cibomahto/Popped/PoppingUnit-Case/PoppingUnitStackup.SLDASM

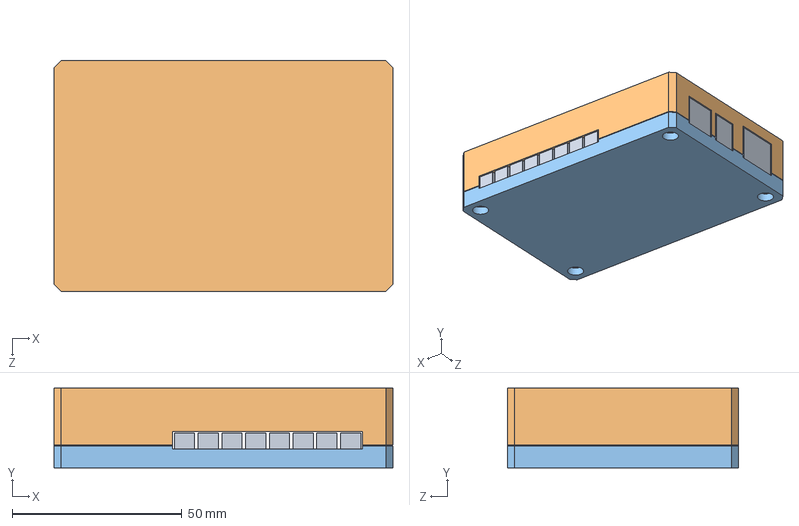
[picture p1: CAD file, 2014-03-11]
PoppingUnit-Case/PoppingUnitStackup.SLDASM
100.0 x 23.5 x 68.0 mm
PoppingUnitPCB
PoppingUnitTop
PoppingUnitBottom
