cibomahto/Popped/PoppingUnit-Case/PoppingUnitBottom.SLDPRT

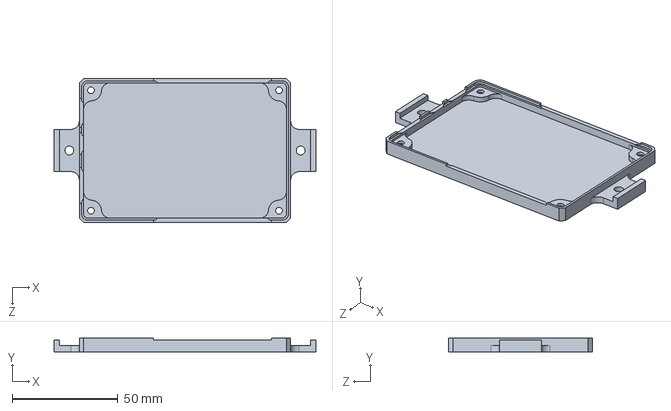
[picture p2: CAD file, 2014-03-11]
PoppingUnit-Case/PoppingUnitBottom.SLDPRT
124.0 x 6.50 x 68.0 mm
