cibomahto/Popped/PoppingUnit-Case/PoppingUnitTop.SLDPRT

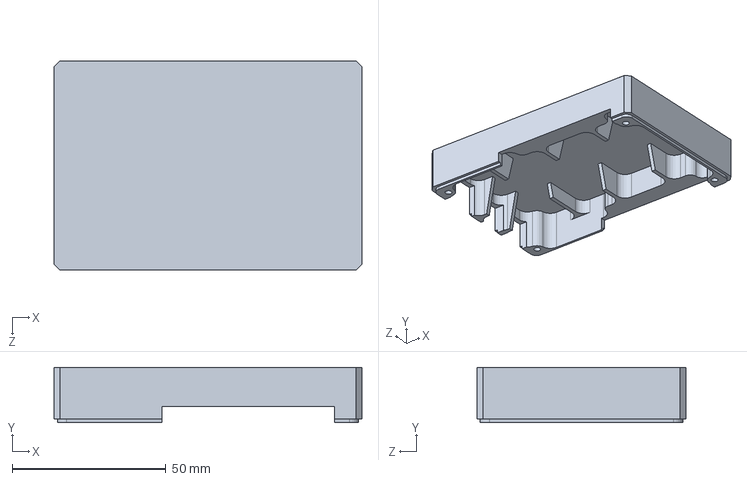
[picture p3: CAD file, 2014-03-11]
PoppingUnit-Case/PoppingUnitTop.SLDPRT
100.0 x 18.0 x 68.0 mm
