cibomahto/Popped/PoppingUnit-Case/PoppingUnitPCB.SLDPRT

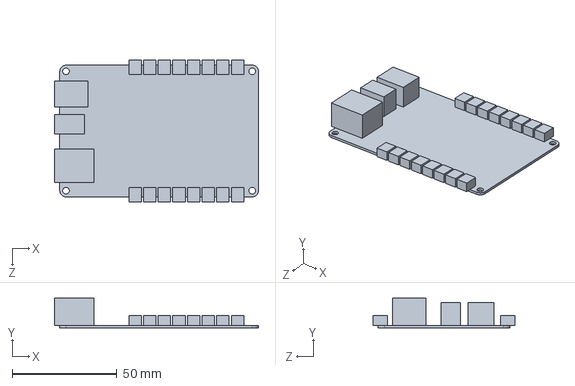
[picture p4: CAD file, 2014-03-05]
PoppingUnit-Case/PoppingUnitPCB.SLDPRT
97.5 x 14.2 x 68.0 mm
