cibomahto/Popped/(list of files, cad)

Other CAD files:
PoppingUnit-Case/PoppingUnitBottom.SLDDRW
PoppingUnit-Case/PoppingUnitTop.SLDDRW
