cibomahto/Popped/PoppingUnit-PCB/PoppingUnit.brd

## EAGLE design PoppingUnit-PCB/PoppingUnit.brd (2014-03-24)

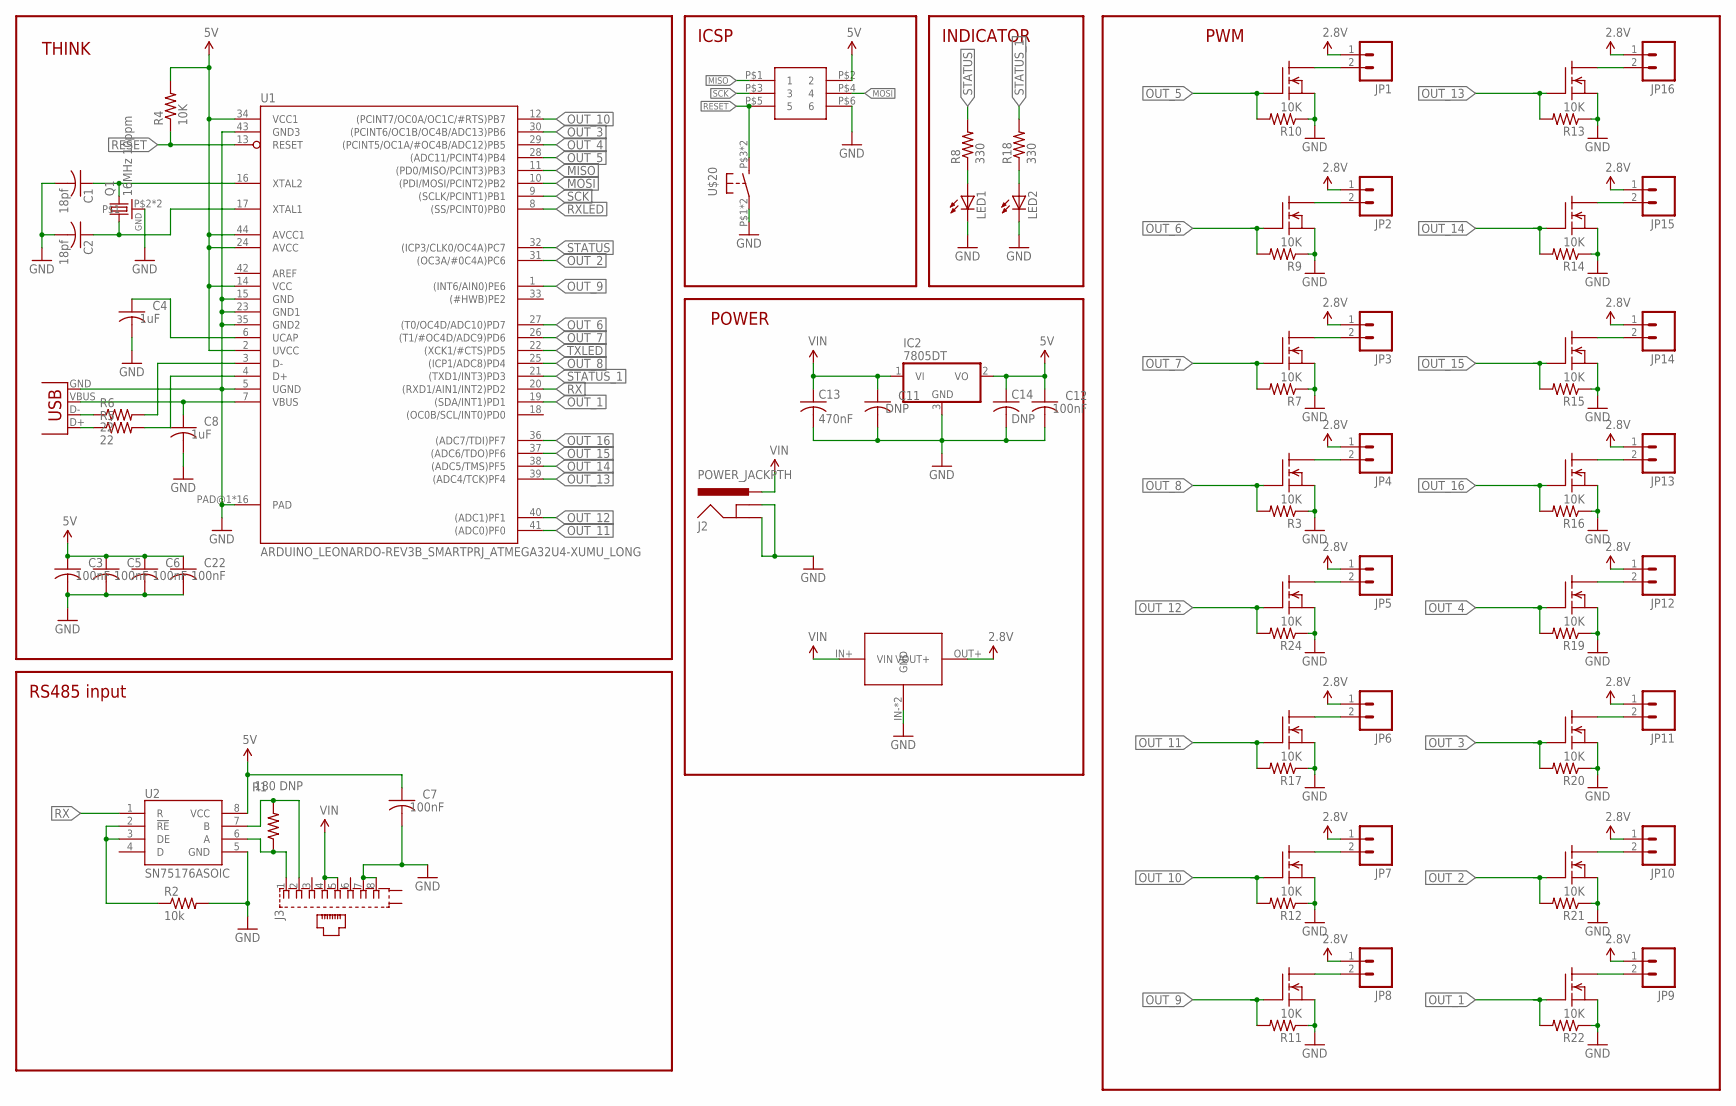
[picture p5: schematic PoppingUnit.sch]

Parts:
C1, C2: 18pf; C0603K
C3, C5, C6, C7, C12, C22: 100nF; C0603K
C4, C8: 1uF; C0603K
C11, C14: DNP; C0603K
C13: 470nF; C0603K
IC2: 7805DT; TO252
J2: POWER_JACKPTH; POWER_JACK_PTH
J3: 555153-1
JP1, JP2, JP3, JP4, JP5, JP6, JP7, JP8, JP9, JP10, JP11, JP12, JP13, JP14, JP15, JP16: M02-JST-2-PTH-NO_SILK; JST-2-PTH-NS
LED1, LED2: LED5MM
Q1: 16MHz 10ppm; CRSYTAL_2520
R1: 180 DNP; R0603
R2: 10k; R0603
R3, R4, R7, R9, R10, R11, R12, R13, R14, R15, R16, R17, R19, R20, R21, R22, R24: 10K; R0603
R5, R6: 22; R0603
R8, R18: 330; R0603
U1: ARDUINO_LEONARDO-REV3B_SMARTPRJ_ATMEGA32U4-XUMU_L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; QFN44ML7X7_LONGLEADS
U2: SN75176ASOIC; SO08
U$1, U$3, U$4, U$5, U$6, U$7, U$8, U$9, U$10, U$11, U$12, U$14, U$15, U$16, U$17, U$18: N_MOSFET; TO252
U$2: 2X3HEADER
U$19: DC_DC; DSN2596
U$20: BUTTON_MOMENTARY; BUTTON_MOMENTARY_KMR211G
X1: USBPTH; USB-B-PTH

Connections:
2.8V: JP1.1, JP2.1, JP3.1, JP4.1, JP5.1, JP6.1, JP7.1, JP8.1, JP9.1, JP10.1, JP11.1, JP12.1, JP13.1, JP14.1, JP15.1, JP16.1, U$19.OUT+ (VOUT+)
5V: C3.1, C5.1, C6.1, C7.1, C12.1, C14.1, C22.1, IC2.2 (VO), R4.2, U1.2 (UVCC), U1.14 (VCC), U1.24 (AVCC), U1.34 (VCC1), U1.44 (AVCC1), U2.8 (VCC), U$2.P$2 (2)
AREF: U1.42 (AREF)
CONNECT_ME: R2.1, U2.2 (!RE), U2.3 (DE)
GND: C1.2, C2.2, C3.2, C4.2, C5.2, C6.2, C7.2, C8.2, C11.2, C12.2, C13.2, C14.2, C22.2, IC2.3 (GND), J2.GND, J2.GNDBREAK, J3.7, J3.8, LED1.K (C), LED2.K (C), Q1.P$2, Q1.P$4, R2.2, R3.1, R7.1, R9.1, R10.1, R11.1, R12.1, R13.1, R14.1, R15.1, R16.1, R17.1, R19.1, R20.1, R21.1, R22.1, R24.1, U1.5 (UGND), U1.15 (GND), U1.23 (GND1), U1.35 (GND2), U1.43 (GND3), U1.PAD@1 (PAD), U1.PAD@2 (PAD), U1.PAD@3 (PAD), U1.PAD@4 (PAD), U1.PAD@5 (PAD), U1.PAD@6 (PAD), U1.PAD@7 (PAD), U1.PAD@8 (PAD), U1.PAD@9 (PAD), U1.PAD@10 (PAD), U1.PAD@11 (PAD), U1.PAD@12 (PAD), U1.PAD@13 (PAD), U1.PAD@14 (PAD), U1.PAD@15 (PAD), U1.PAD@16 (PAD), U2.5 (GND), U$1.P$2 (S), U$2.P$6 (6), U$3.P$2 (S), U$4.P$2 (S), U$5.P$2 (S), U$6.P$2 (S), U$7.P$2 (S), U$8.P$2 (S), U$9.P$2 (S), U$10.P$2 (S), U$11.P$2 (S), U$12.P$2 (S), U$14.P$2 (S), U$15.P$2 (S), U$16.P$2 (S), U$17.P$2 (S), U$18.P$2 (S), U$19.IN- (GND), U$19.OUT- (GND), U$20.P$1, U$20.P$2, X1.GND
MISO: U1.11 ((PD0/MISO/PCINT3)PB3), U$2.P$1 (1)
MOSI: U1.10 ((PDI/MOSI/PCINT2)PB2), U$2.P$4 (4)
unnamed: R6.1, X1.D-
unnamed: C1.1, Q1.P$3 (2), U1.16 (XTAL2)
unnamed: R5.1, X1.D+
unnamed: R5.2, U1.4 (D+)
unnamed: C2.1, Q1.P$1 (1), U1.17 (XTAL1)
unnamed: R6.2, U1.3 (D-)
unnamed: C8.1, U1.7 (VBUS), X1.VBUS
unnamed: LED1.A, R8.1
unnamed: C4.1, U1.6 (UCAP)
unnamed: JP11.2, U$16.P$3 (D)
unnamed: JP1.2, U$1.P$3 (D)
unnamed: LED2.A, R18.1
unnamed: JP2.2, U$3.P$3 (D)
unnamed: JP3.2, U$4.P$3 (D)
unnamed: JP4.2, U$5.P$3 (D)
unnamed: JP5.2, U$10.P$3 (D)
unnamed: JP6.2, U$11.P$3 (D)
unnamed: JP7.2, U$12.P$3 (D)
unnamed: JP8.2, U$14.P$3 (D)
unnamed: JP9.2, U$18.P$3 (D)
unnamed: JP10.2, U$17.P$3 (D)
unnamed: JP12.2, U$15.P$3 (D)
unnamed: JP13.2, U$9.P$3 (D)
unnamed: JP14.2, U$8.P$3 (D)
unnamed: JP15.2, U$7.P$3 (D)
unnamed: JP16.2, U$6.P$3 (D)
OUT_1: R22.2, U1.19 ((SDA/INT1)PD1), U$18.P$1 (G)
OUT_2: R21.2, U1.31 ((OC3A/#0C4A)PC6), U$17.P$1 (G)
OUT_3: R20.2, U1.30 ((PCINT6/OC1B/OC4B/ADC13)PB6), U$16.P$1 (G)
OUT_4: R19.2, U1.29 ((PCINT5/OC1A/#OC4B/ADC12)PB5), U$15.P$1 (G)
OUT_5: R10.2, U1.28 ((ADC11/PCINT4)PB4), U$1.P$1 (G)
OUT_6: R9.2, U1.27 ((T0/OC4D/ADC10)PD7), U$3.P$1 (G)
OUT_7: R7.2, U1.26 ((T1/#OC4D/ADC9)PD6), U$4.P$1 (G)
OUT_8: R3.2, U1.25 ((ICP1/ADC8)PD4), U$5.P$1 (G)
OUT_9: R11.2, U1.1 ((INT6/AIN0)PE6), U$14.P$1 (G)
OUT_10: R12.2, U1.12 ((PCINT7/OC0A/OC1C/#RTS)PB7), U$12.P$1 (G)
OUT_11: R17.2, U1.41 ((ADC0)PF0), U$11.P$1 (G)
OUT_12: R24.2, U1.40 ((ADC1)PF1), U$10.P$1 (G)
OUT_13: R13.2, U1.39 ((ADC4/TCK)PF4), U$6.P$1 (G)
OUT_14: R14.2, U1.38 ((ADC5/TMS)PF5), U$7.P$1 (G)
OUT_15: R15.2, U1.37 ((ADC6/TDO)PF6), U$8.P$1 (G)
OUT_16: R16.2, U1.36 ((ADC7/TDI)PF7), U$9.P$1 (G)
RESET: R4.1, U1.13 (RESET), U$2.P$5 (5), U$20.P$3 (S), U$20.P$4 (S)
RS485A: J3.1, R1.1, U2.6 (A)
RS485B: J3.2, R1.2, U2.7 (B)
RX: U1.20 ((RXD1/AIN1/INT2)PD2), U2.1 (R)
RXLED: U1.8 ((SS/PCINT0)PB0)
SCK: U1.9 ((SCLK/PCINT1)PB1), U$2.P$3 (3)
STATUS: R8.2, U1.32 ((ICP3/CLK0/OC4A)PC7)
STATUS_1: R18.2, U1.21 ((TXD1/INT3)PD3)
TXLED: U1.22 ((XCK1/#CTS)PD5)
VIN: C11.1, C13.1, IC2.1 (VI), J2.PWR, J3.4, J3.5, U$19.IN+ (VIN)

Notes on the sheet:
RS485 input
ICSP
INDICATOR
PWM
POWER
THINK

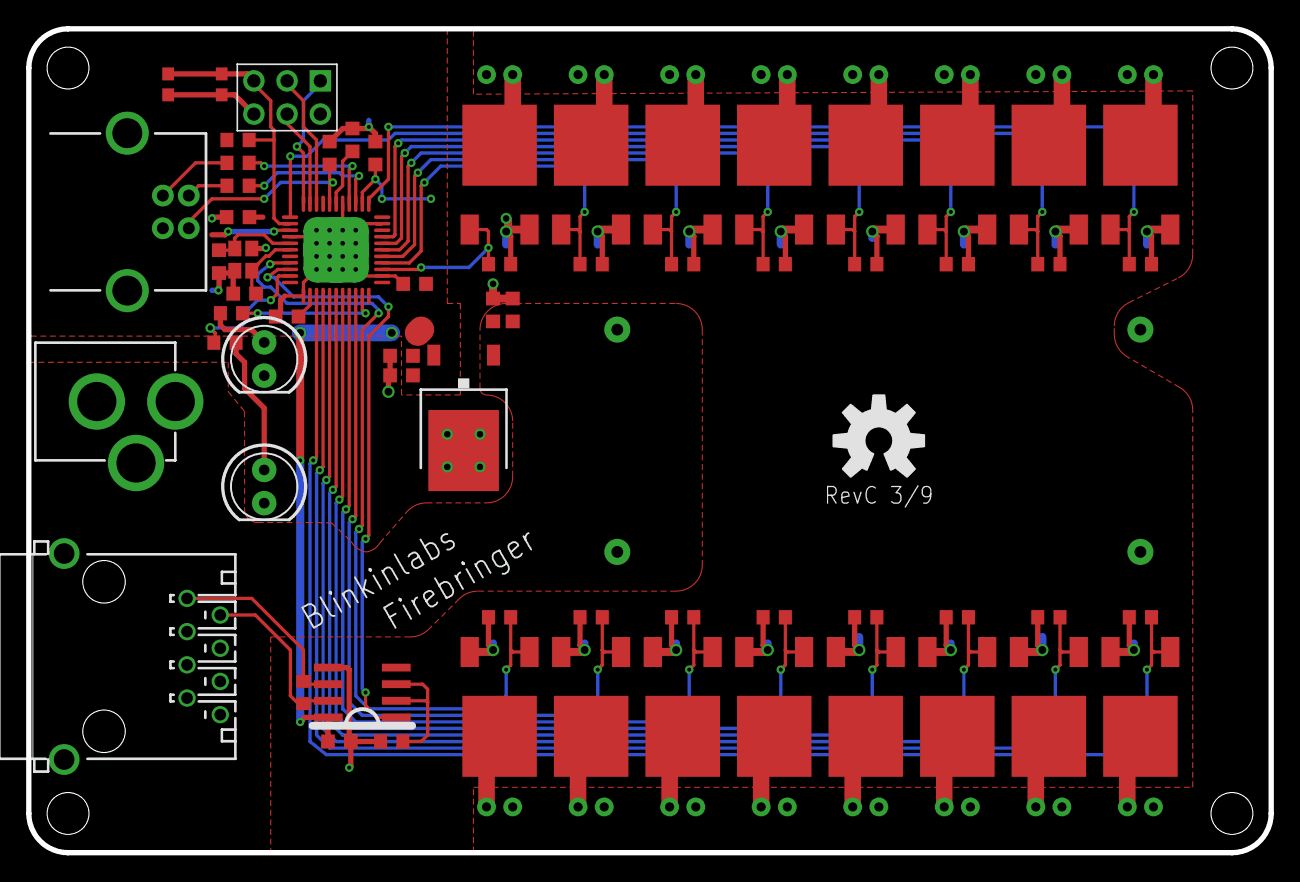
[picture p6: board PoppingUnit.brd from above]

Board: 2 copper layers, 95.0 x 63.0 mm, 81 parts (0 on the bottom side), 56 nets.

Other parts of the board:
U$13: OSHW-LOGO-L
