cibomahto/Popped/PowerDistribution-PCB/PowerDistribution.brd

## EAGLE design PowerDistribution-PCB/PowerDistribution.brd (2014-03-08)

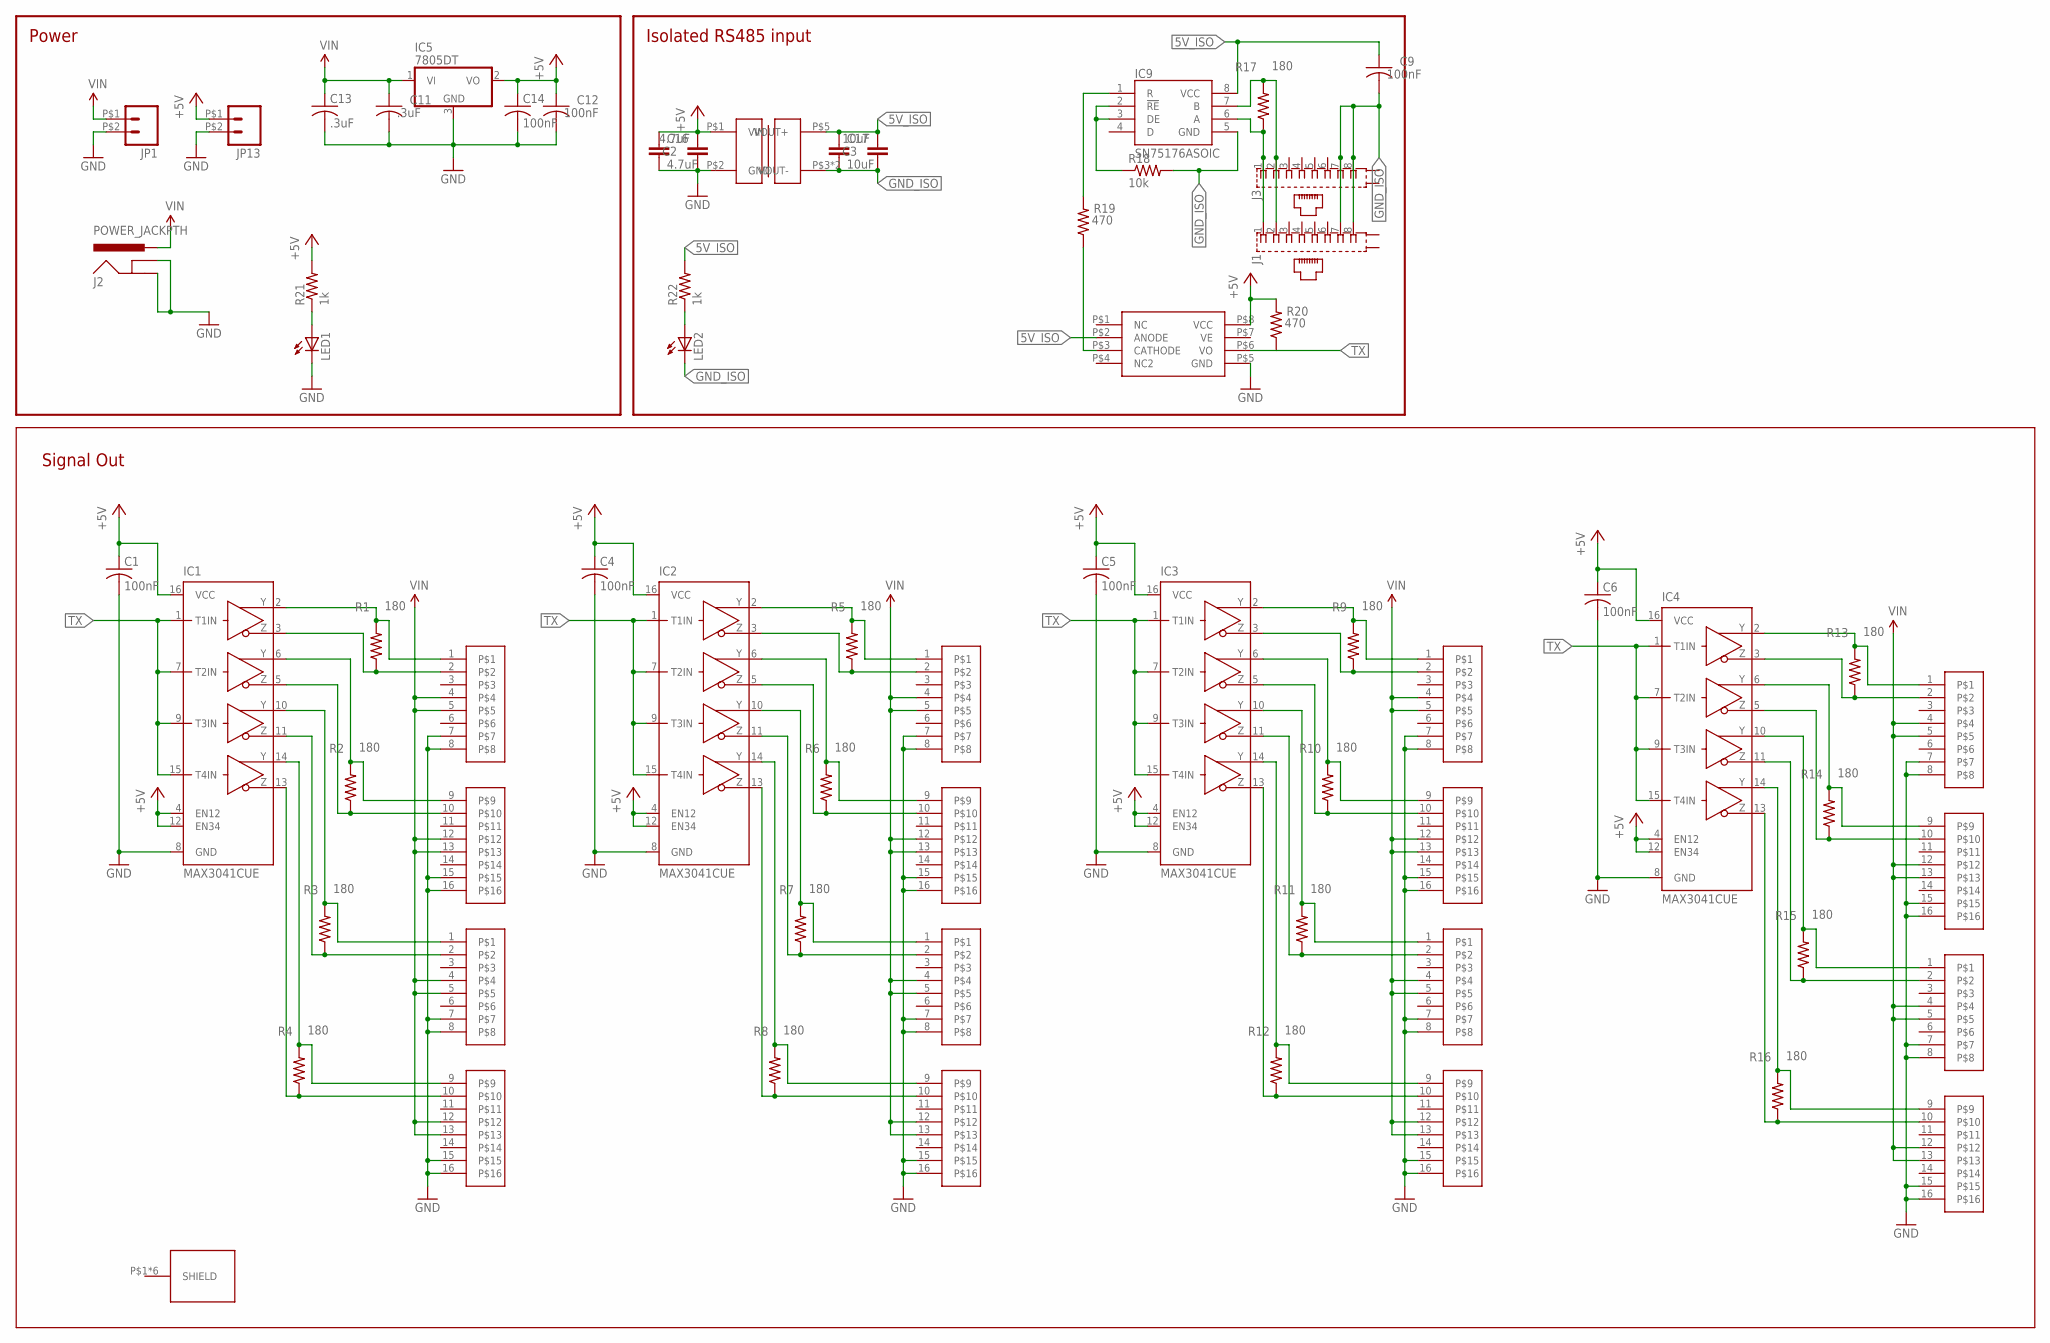
[picture p7: schematic PowerDistribution.sch]

Parts:
C1, C4, C5, C6, C9: 100nF; C0603
C2: 4.7uF; 0805
C3: 10uF; 0805
C11, C13: .3uF; C0603K
C12, C14: 100nF; C0603K
C16: 4.7uF; 1210
C17: 10uF; 1210
IC1, IC2, IC3, IC4: MAX3041CUE; TSSOP16
IC5: 7805DT; TO252
IC9: SN75176ASOIC; SO08
J1, J3: 555153-1
J2: POWER_JACKPTH; POWER_JACK_PTH
JP1, JP13: M026.35MM; SCREWTERMINAL-6.35MM-2
LED1, LED2: LED5MM
R1, R2, R3, R4, R5, R6, R7, R8, R9, R10, R11, R12, R13, R14, R15, R16, R17: 180; R0603
R18: 10k; R0603
R19, R20: 470; R0603
R21, R22: 1k; R0603
U$1, U$2, U$5, U$6, U$7, U$8, U$9, U$11: RJ45_8X2_JACK
U$3: 6N137; 8_SOIC
U$4: RJ45_8X2_BASE
U$10: DC_DC_ISOLATED_0505; IB_XLS-1W

Connections:
5V_ISO: C3.2, C9.1, C17.1, IC9.8 (VCC), R22.2, U$3.P$2 (ANODE), U$10.P$5 (VOUT+)
+5V: C1.1, C2.2, C4.1, C5.1, C6.1, C12.1, C14.1, C16.1, IC1.4 (EN12), IC1.12 (EN34), IC1.16 (VCC), IC2.4 (EN12), IC2.12 (EN34), IC2.16 (VCC), IC3.4 (EN12), IC3.12 (EN34), IC3.16 (VCC), IC4.4 (EN12), IC4.12 (EN34), IC4.16 (VCC), IC5.2 (VO), JP13.P$1 (1), R20.2, R21.2, U$3.P$8 (VCC), U$10.P$1 (VIN)
D9: IC9.2 (!RE), IC9.3 (DE), R18.1
GND: C1.2, C2.1, C4.2, C5.2, C6.2, C11.2, C12.2, C13.2, C14.2, C16.2, IC1.8 (GND), IC2.8 (GND), IC3.8 (GND), IC4.8 (GND), IC5.3 (GND), J2.GND, J2.GNDBREAK, JP1.P$2 (2), JP13.P$2 (2), LED1.K (C), U$1.7, U$1.8, U$1.15, U$1.16, U$2.7, U$2.8, U$2.15, U$2.16, U$3.P$5 (GND), U$5.7, U$5.8, U$5.15, U$5.16, U$6.7, U$6.8, U$6.15, U$6.16, U$7.7, U$7.8, U$7.15, U$7.16, U$8.7, U$8.8, U$8.15, U$8.16, U$9.7, U$9.8, U$9.15, U$9.16, U$10.P$2 (GND), U$11.7, U$11.8, U$11.15, U$11.16
GND_ISO: C3.1, C9.2, C17.2, IC9.5 (GND), J1.7, J1.8, J3.7, J3.8, LED2.K (C), R18.2, U$10.P$3 (VOUT-), U$10.P$4 (VOUT-)
unnamed: R19.1, U$3.P$3 (CATHODE)
unnamed: IC1.2 (Y1), R1.2, U$5.1
unnamed: IC9.1 (R), R19.2
unnamed: IC1.3 (Z1), R1.1, U$5.2
unnamed: IC1.13 (Z4), R4.1, U$8.10
unnamed: IC1.14 (Y4), R4.2, U$8.9
unnamed: IC1.11 (Z3), R3.1, U$8.2
unnamed: IC2.2 (Y1), R5.2, U$1.1
unnamed: IC1.10 (Y3), R3.2, U$8.1
unnamed: IC1.5 (Z2), R2.1, U$5.10
unnamed: IC1.6 (Y2), R2.2, U$5.9
unnamed: IC2.3 (Z1), R5.1, U$1.2
unnamed: IC2.13 (Z4), R8.1, U$2.10
unnamed: IC2.14 (Y4), R8.2, U$2.9
unnamed: IC2.11 (Z3), R7.1, U$2.2
unnamed: IC2.5 (Z2), R6.1, U$1.10
unnamed: IC2.6 (Y2), R6.2, U$1.9
unnamed: IC2.10 (Y3), R7.2, U$2.1
unnamed: IC3.2 (Y1), R9.2, U$6.1
unnamed: IC3.3 (Z1), R9.1, U$6.2
unnamed: IC3.13 (Z4), R12.1, U$7.10
unnamed: IC3.14 (Y4), R12.2, U$7.9
unnamed: IC3.11 (Z3), R11.1, U$7.2
unnamed: IC3.5 (Z2), R10.1, U$6.10
unnamed: IC3.6 (Y2), R10.2, U$6.9
unnamed: IC3.10 (Y3), R11.2, U$7.1
unnamed: IC4.2 (Y1), R13.2, U$9.1
unnamed: IC4.3 (Z1), R13.1, U$9.2
unnamed: IC4.13 (Z4), R16.1, U$11.10
unnamed: IC4.14 (Y4), R16.2, U$11.9
unnamed: IC4.11 (Z3), R15.1, U$11.2
unnamed: IC4.5 (Z2), R14.1, U$9.10
unnamed: IC4.6 (Y2), R14.2, U$9.9
unnamed: IC4.10 (Y3), R15.2, U$11.1
unnamed: LED1.A, R21.1
unnamed: LED2.A, R22.1
RS485A9: IC9.6 (A), J1.1, J3.1, R17.1
RS485B9: IC9.7 (B), J1.2, J3.2, R17.2
TX: IC1.1 (T1IN), IC1.7 (T2IN), IC1.9 (T3IN), IC1.15 (T4IN), IC2.1 (T1IN), IC2.7 (T2IN), IC2.9 (T3IN), IC2.15 (T4IN), IC3.1 (T1IN), IC3.7 (T2IN), IC3.9 (T3IN), IC3.15 (T4IN), IC4.1 (T1IN), IC4.7 (T2IN), IC4.9 (T3IN), IC4.15 (T4IN), R20.1, U$3.P$6 (VO)
VIN: C11.1, C13.1, IC5.1 (VI), J2.PWR, JP1.P$1 (1), U$1.4, U$1.5, U$1.12, U$1.13, U$2.4, U$2.5, U$2.12, U$2.13, U$5.4, U$5.5, U$5.12, U$5.13, U$6.4, U$6.5, U$6.12, U$6.13, U$7.4, U$7.5, U$7.12, U$7.13, U$8.4, U$8.5, U$8.12, U$8.13, U$9.4, U$9.5, U$9.12, U$9.13, U$11.4, U$11.5, U$11.12, U$11.13

Notes on the sheet:
Isolated RS485 input
Signal Out
Power

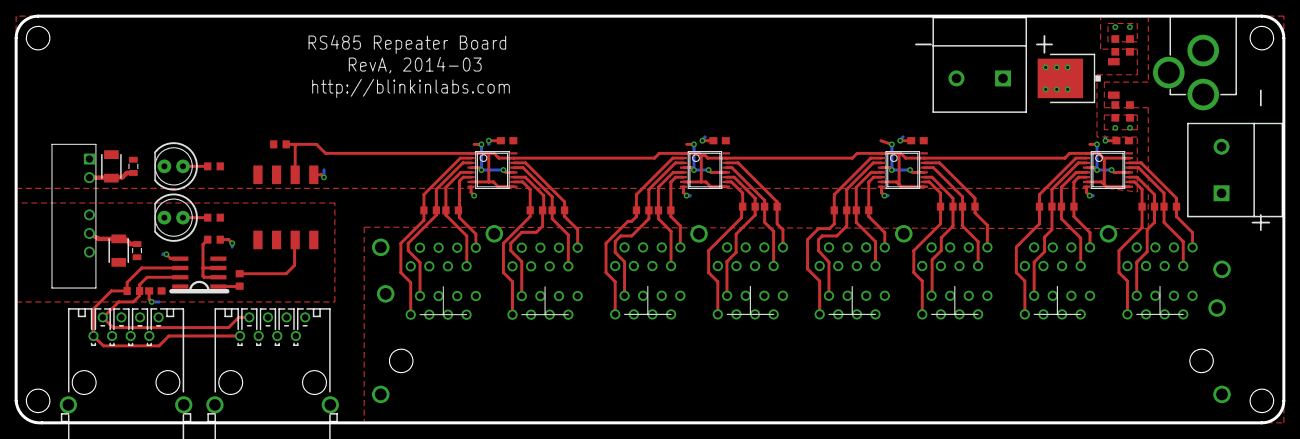
[picture p8: board PowerDistribution.brd from above]

Board: 2 copper layers, 173.0 x 55.5 mm, 59 parts (0 on the bottom side), 45 nets.
