cibomahto/Popped/PoppingElement-PCB/PoppingElement-array.brd

## EAGLE design PoppingElement-PCB/PoppingElement-array.brd (2014-03-11)

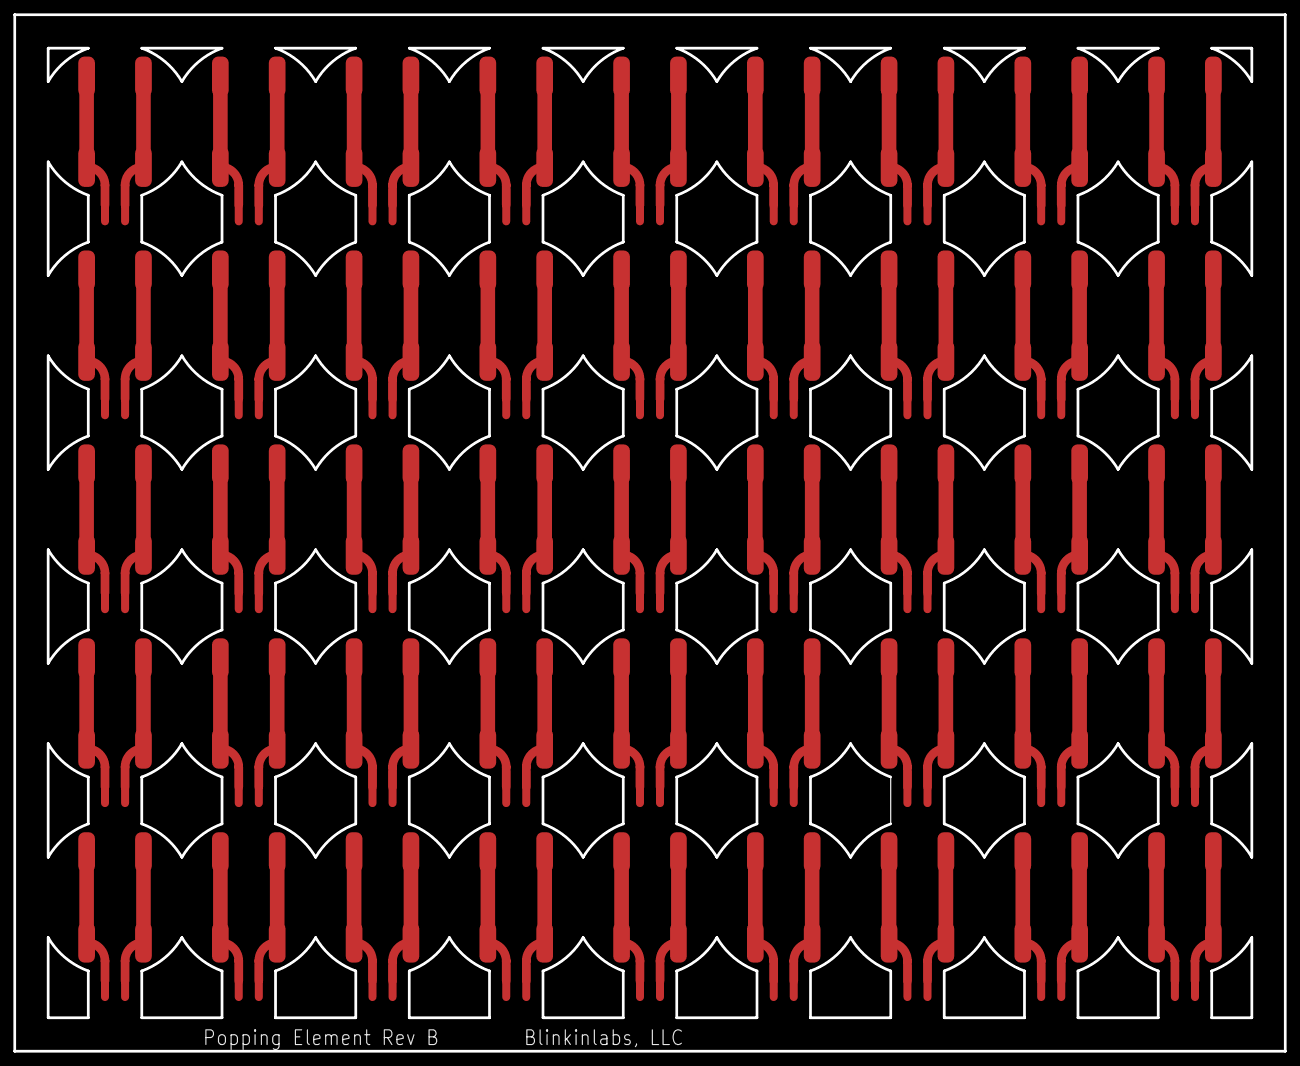
[picture p9: board PoppingElement-array.brd from above]

Board: 2 copper layers, 190.0 x 155.0 mm, 90 parts (0 on the bottom side), 90 nets.

Parts:
U$1, U$5, U$7, U$9, U$11, U$13, U$15, U$17, U$19, U$21, U$23, U$25, U$27, U$29, U$31, U$33, U$35, U$37, U$39, U$41, U$43, U$45, U$47, U$49, U$51, U$53, U$55, U$57, U$59, U$61, U$63, U$65, U$67, U$69, U$71, U$73, U$75, U$77, U$79, U$81, U$83, U$85, U$87, U$89, U$91: CIGARETTE_LIGHTER
U$2, U$6, U$8, U$10, U$12, U$14, U$16, U$18, U$20, U$22, U$24, U$26, U$28, U$30, U$32, U$34, U$36, U$38, U$40, U$42, U$44, U$46, U$48, U$50, U$52, U$54, U$56, U$58, U$60, U$62, U$64, U$66, U$68, U$70, U$72, U$74, U$76, U$78, U$80, U$82, U$84, U$86, U$88, U$90, U$92: M02; PADS_2MMX2

Connections:
unnamed: U$1.P$1, U$1.P$3, U$2.P$2
unnamed: U$1.P$2, U$1.P$4, U$2.P$1
unnamed: U$5.P$1, U$5.P$3, U$6.P$2
unnamed: U$5.P$2, U$5.P$4, U$6.P$1
unnamed: U$7.P$1, U$7.P$3, U$8.P$2
unnamed: U$7.P$2, U$7.P$4, U$8.P$1
unnamed: U$9.P$1, U$9.P$3, U$10.P$2
unnamed: U$9.P$2, U$9.P$4, U$10.P$1
unnamed: U$11.P$1, U$11.P$3, U$12.P$2
unnamed: U$11.P$2, U$11.P$4, U$12.P$1
unnamed: U$13.P$1, U$13.P$3, U$14.P$2
unnamed: U$13.P$2, U$13.P$4, U$14.P$1
unnamed: U$15.P$1, U$15.P$3, U$16.P$2
unnamed: U$15.P$2, U$15.P$4, U$16.P$1
unnamed: U$21.P$1, U$21.P$3, U$22.P$2
unnamed: U$17.P$1, U$17.P$3, U$18.P$2
unnamed: U$17.P$2, U$17.P$4, U$18.P$1
unnamed: U$19.P$1, U$19.P$3, U$20.P$2
unnamed: U$19.P$2, U$19.P$4, U$20.P$1
unnamed: U$21.P$2, U$21.P$4, U$22.P$1
unnamed: U$31.P$1, U$31.P$3, U$32.P$2
unnamed: U$23.P$1, U$23.P$3, U$24.P$2
unnamed: U$23.P$2, U$23.P$4, U$24.P$1
unnamed: U$25.P$1, U$25.P$3, U$26.P$2
unnamed: U$25.P$2, U$25.P$4, U$26.P$1
unnamed: U$27.P$1, U$27.P$3, U$28.P$2
unnamed: U$27.P$2, U$27.P$4, U$28.P$1
unnamed: U$29.P$1, U$29.P$3, U$30.P$2
unnamed: U$29.P$2, U$29.P$4, U$30.P$1
unnamed: U$31.P$2, U$31.P$4, U$32.P$1
unnamed: U$33.P$1, U$33.P$3, U$34.P$2
unnamed: U$33.P$2, U$33.P$4, U$34.P$1
unnamed: U$35.P$1, U$35.P$3, U$36.P$2
unnamed: U$35.P$2, U$35.P$4, U$36.P$1
unnamed: U$37.P$1, U$37.P$3, U$38.P$2
unnamed: U$37.P$2, U$37.P$4, U$38.P$1
unnamed: U$39.P$1, U$39.P$3, U$40.P$2
unnamed: U$39.P$2, U$39.P$4, U$40.P$1
unnamed: U$41.P$1, U$41.P$3, U$42.P$2
unnamed: U$41.P$2, U$41.P$4, U$42.P$1
unnamed: U$43.P$1, U$43.P$3, U$44.P$2
unnamed: U$43.P$2, U$43.P$4, U$44.P$1
unnamed: U$45.P$1, U$45.P$3, U$46.P$2
unnamed: U$45.P$2, U$45.P$4, U$46.P$1
unnamed: U$47.P$1, U$47.P$3, U$48.P$2
unnamed: U$47.P$2, U$47.P$4, U$48.P$1
unnamed: U$49.P$1, U$49.P$3, U$50.P$2
unnamed: U$49.P$2, U$49.P$4, U$50.P$1
unnamed: U$51.P$1, U$51.P$3, U$52.P$2
unnamed: U$51.P$2, U$51.P$4, U$52.P$1
unnamed: U$53.P$1, U$53.P$3, U$54.P$2
unnamed: U$53.P$2, U$53.P$4, U$54.P$1
unnamed: U$55.P$1, U$55.P$3, U$56.P$2
unnamed: U$55.P$2, U$55.P$4, U$56.P$1
unnamed: U$57.P$1, U$57.P$3, U$58.P$2
unnamed: U$57.P$2, U$57.P$4, U$58.P$1
unnamed: U$59.P$1, U$59.P$3, U$60.P$2
unnamed: U$59.P$2, U$59.P$4, U$60.P$1
unnamed: U$61.P$1, U$61.P$3, U$62.P$2
unnamed: U$61.P$2, U$61.P$4, U$62.P$1
unnamed: U$63.P$1, U$63.P$3, U$64.P$2
unnamed: U$63.P$2, U$63.P$4, U$64.P$1
unnamed: U$65.P$1, U$65.P$3, U$66.P$2
unnamed: U$65.P$2, U$65.P$4, U$66.P$1
unnamed: U$67.P$1, U$67.P$3, U$68.P$2
unnamed: U$67.P$2, U$67.P$4, U$68.P$1
unnamed: U$69.P$1, U$69.P$3, U$70.P$2
unnamed: U$69.P$2, U$69.P$4, U$70.P$1
unnamed: U$71.P$1, U$71.P$3, U$72.P$2
unnamed: U$71.P$2, U$71.P$4, U$72.P$1
unnamed: U$73.P$1, U$73.P$3, U$74.P$2
unnamed: U$73.P$2, U$73.P$4, U$74.P$1
unnamed: U$75.P$1, U$75.P$3, U$76.P$2
unnamed: U$75.P$2, U$75.P$4, U$76.P$1
unnamed: U$77.P$1, U$77.P$3, U$78.P$2
unnamed: U$77.P$2, U$77.P$4, U$78.P$1
unnamed: U$79.P$1, U$79.P$3, U$80.P$2
unnamed: U$79.P$2, U$79.P$4, U$80.P$1
unnamed: U$81.P$1, U$81.P$3, U$82.P$2
unnamed: U$81.P$2, U$81.P$4, U$82.P$1
unnamed: U$83.P$1, U$83.P$3, U$84.P$2
unnamed: U$83.P$2, U$83.P$4, U$84.P$1
unnamed: U$85.P$1, U$85.P$3, U$86.P$2
unnamed: U$85.P$2, U$85.P$4, U$86.P$1
unnamed: U$87.P$1, U$87.P$3, U$88.P$2
unnamed: U$87.P$2, U$87.P$4, U$88.P$1
unnamed: U$89.P$1, U$89.P$3, U$90.P$2
unnamed: U$89.P$2, U$89.P$4, U$90.P$1
unnamed: U$91.P$1, U$91.P$3, U$92.P$2
unnamed: U$91.P$2, U$91.P$4, U$92.P$1
