cibomahto/Popped/PoppingUnit_Firmware/PoppingUnit_Firmware.ino

#include "Protocol.h"
#include "PoppingOutput.h"


// Address that this device responds to. Change this for each board.
#define DEVICE_ADDRESS   31

// System baud rate. Leave at 9600
#define BAUD_RATE 9600

#define PIN_STATUS_LED    13  // PC7

Protocol usbReceiver;
Protocol rs485Receiver;

PoppingOutput popper;

#define SIGNAL_DISPLAY_TIMEOUT 200  // Number of seconds to continue flashing the display LED, 
long lastSignalTime;                // The last time (in millis()) that a serial byte was received
boolean isFlashing = false;         // True if the status LED is currently flashing


// Set the status LED to be on, not flashing
void stopFlashing() {
  analogWrite(PIN_STATUS_LED, 255);
  isFlashing = false;
}

// Start flashing the status LED, if it's not already flashing
void startFlashing() {
  // Avoid disturbing the output pin if we are already in flash mode
  if(!isFlashing) {
    analogWrite(PIN_STATUS_LED, 128);
    isFlashing = true;
  }
}

void setup() {
  // USB input (The baud rate specified here doesn't matter)
  Serial.begin(115200);
  usbReceiver.reset();

  // RS485 input
  Serial1.begin(BAUD_RATE);
  rs485Receiver.reset();
    
  // Status LEDs
  stopFlashing();

  // Set timer4 to a slow mode, so that PIN_STATUS_LED light PWMs at a visible rate  
  TCCR4B |= (1<<CS43) | (1<<CS42) | (1<<CS41) | (1<<CS40);
  
  // Popping outputs
  popper.init();
}

bool handleData(uint8_t dataSize, uint16_t* data) {
//  // Heartbeat message: Just flash the LED
//  // Length: 2
//  // [bytes 0-1]: 0x1234
//  if (dataSize == 2 && data[0] == 0x1234) {
//    return true;
//  }
  
  // Pop message: Pop a specific balloon
  // [bytes 0-1]: Address of balloon to pop
  // [bytes 2-3]: Length of time to heat element, in ms (3000 is best)
  if (dataSize == 4) {
    uint16_t balloon = data[0];
    uint16_t time = data[1];
    
    if(balloon >= DEVICE_ADDRESS*OUTPUT_COUNT
       && balloon < (DEVICE_ADDRESS + 1)*OUTPUT_COUNT) {
      popper.pop(balloon - DEVICE_ADDRESS*OUTPUT_COUNT, time);
    }
  }
}


void loop() {
  // Let the popper update itself
  popper.update();
  
  // If we haven't received any data in a while, set the status LED
  // to stop flashing
  if(millis() > lastSignalTime + SIGNAL_DISPLAY_TIMEOUT) {
    stopFlashing();
  }
  
  // Handle incoming data from USB
  if(Serial.available()) {
    startFlashing();
    lastSignalTime = millis();
    
    if(usbReceiver.parseByte(Serial.read())) {
      uint8_t dataSize = usbReceiver.getPacketSize();
      uint16_t* data = usbReceiver.getPacket16();
      handleData(dataSize, data);
    }
  }

  // Handle incoming data from RS485  
  if(Serial1.available()) {
    startFlashing();
    lastSignalTime = millis();
    
    if(rs485Receiver.parseByte(Serial1.read())) {
      uint8_t dataSize = rs485Receiver.getPacketSize();
      uint16_t* data = rs485Receiver.getPacket16();
      handleData(dataSize, data);
    }
  }
}
