cibomahto/Popped/(commit log)

2014-03-05 Initial commit, PCB design for the Popping Unit and Popping Element
    [PoppingElement-Reverse.brd, PoppingElement-Reverse.sch, PoppingElement.brd, PoppingElement.sch, PoppingUnit.brd, PoppingUnit.sch]
2014-03-05 Add Popping unit case design, as sent for quote
    [PoppingUnitBottom.SLDDRW, PoppingUnitBottom.SLDPRT, PoppingUnitPCB.SLDPRT, PoppingUnitStackup.SLDASM, PoppingUnitTop.SLDDRW, PoppingUnitTop.SLDPRT]
2014-03-08 Update popping unit to RevB (should be good to go!)
    [PoppingUnit.brd, PoppingUnit.sch]
2014-03-08 Add TODO file to PCB
2014-03-08 First draft of power distribution PCB
    [PowerDistribution.brd, PowerDistribution.sch]
2014-03-08 Update Popping Unit PCB for release, send to board house
    [PoppingUnit.brd, PoppingUnit.sch]
2014-03-08 Finish routing power distribution PCB; still need to fit to case
    [PowerDistribution.brd, PowerDistribution.sch]
2014-03-08 Power Distribution: Finish layout, add mouting holes at edges (likely not quite enough), release RevA
    [PowerDistribution.brd, PowerDistribution.sch]
2014-03-09 Update PoppingUnit board to fix bummer mistake (Arduino remuxes TX, so don't use it as an output channel), update firmware to match
    [PoppingUnit.brd, PoppingUnit.sch]
2014-03-11 RevC of the Popping Element case
    [PoppingUnitBottom.SLDDRW, PoppingUnitBottom.SLDPRT, PoppingUnitStackup.SLDASM, PoppingUnitTop.SLDDRW, PoppingUnitTop.SLDPRT]
2014-03-11 Updates to firmware: Separate update() function to avoid crashes
    [PoppingOutput.cpp, PoppingOutput.h, PoppingUnit_Firmware.ino]
2014-03-11 Add Popping Unit board, RevC (manufacturing version)
    [PoppingUnit.brd]
2014-03-11 Add array version of the popping element, and foam outline
    [PoppingElement-array.brd, PoppingElement-foam.brd]
2014-03-11 Fix the name of the popping unit case
    [PoppingUnitBottom.SLDDRW, PoppingUnitBottom.SLDPRT, PoppingUnitPCB.SLDPRT, PoppingUnitStackup.SLDASM, PoppingUnitTop.SLDDRW, PoppingUnitTop.SLDPRT]
2014-03-14 Rename Poppingunit firmware; arduino can't handle a -
2014-03-24 Firmware update: Attempt to prevent glitch in status led
    [PoppingUnit_Firmware.ino]
2014-03-24 Update schematic with production component values
    [PoppingUnit.brd, PoppingUnit.sch]
2014-03-25 Update comments, small cleanups. Status LED glitch is fixed.
    [PoppingOutput.cpp, PoppingOutput.h, PoppingUnit_Firmware.ino]
